theheraldproject/herald-hardware/wearable/images/beacon-usb.png

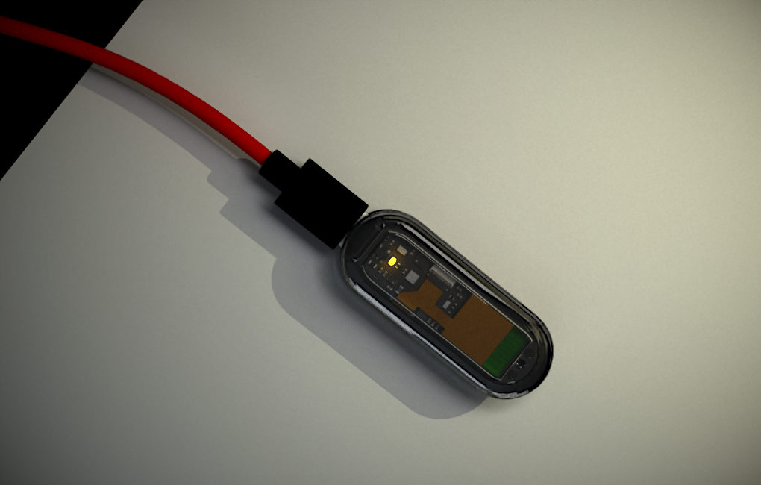
wearable/images/beacon-usb.png
