theheraldproject/herald-hardware/wearable/images/wearable-bracelet.png

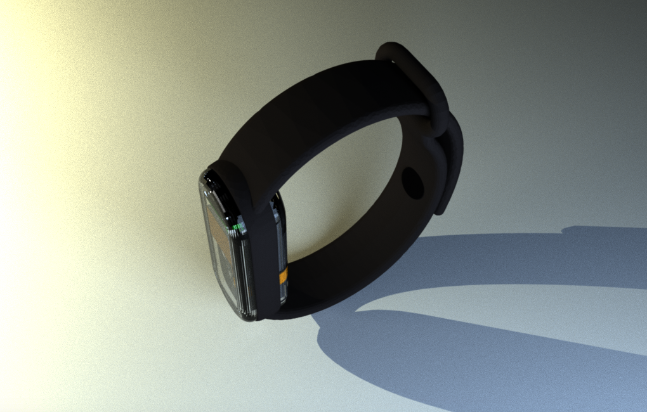
wearable/images/wearable-bracelet.png
