theheraldproject/herald-hardware/wearable/images/wearable-boards.png

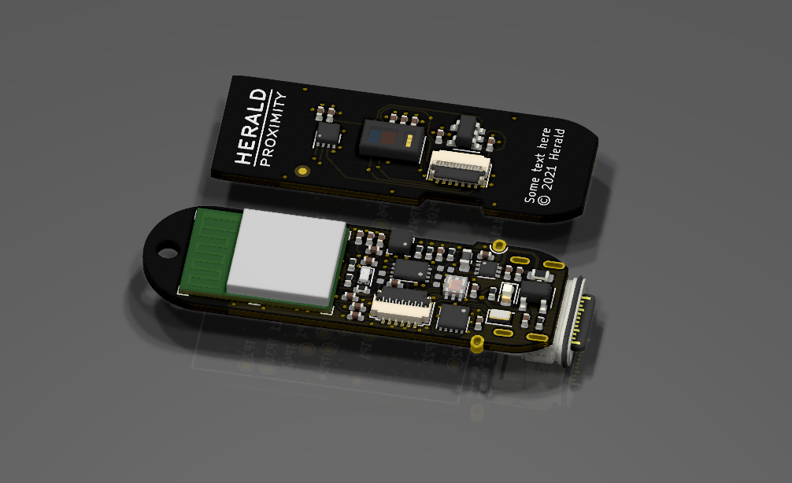
wearable/images/wearable-boards.png
