theheraldproject/herald-hardware/wearable/images/wearable-holder.png

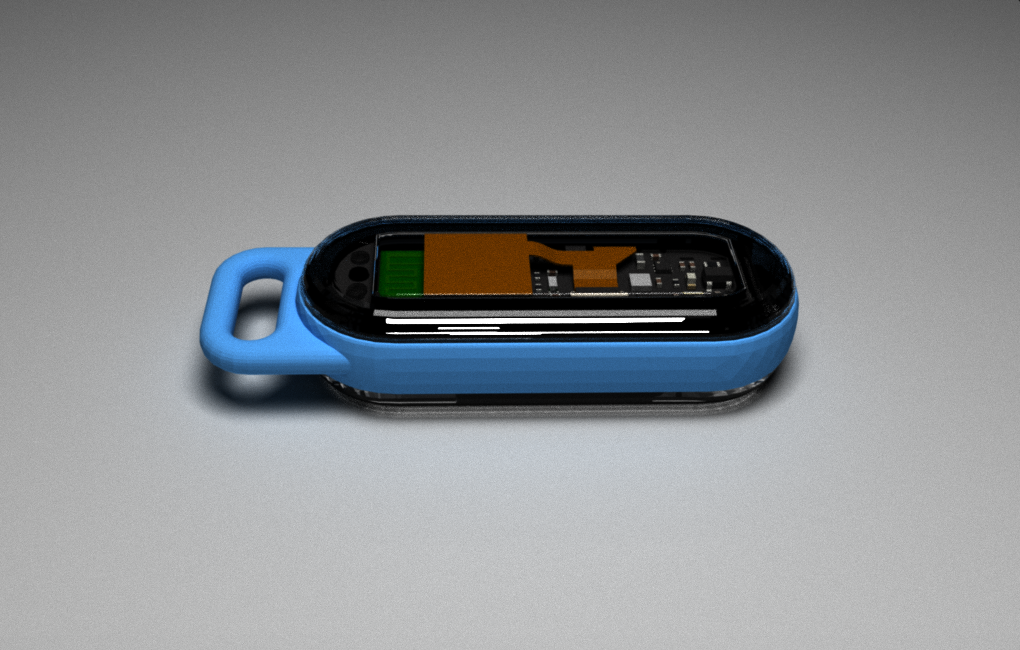
wearable/images/wearable-holder.png
