theheraldproject/herald-hardware/wearable/pcb/wearable.kicad_pcb

## KiCad design wearable/pcb/wearable.kicad_pcb (2021-12-06)

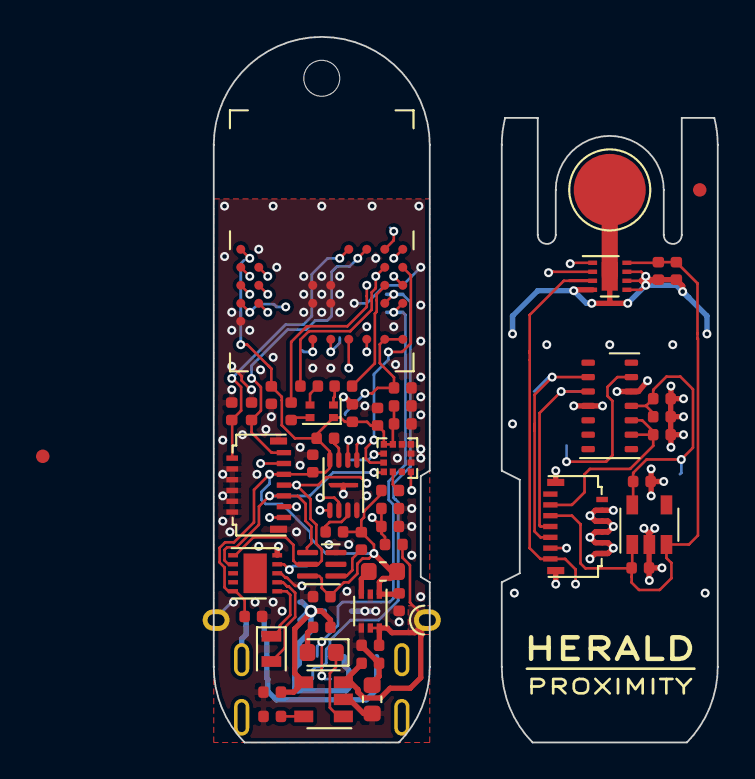
[picture p5: board wearable.kicad_pcb from above]

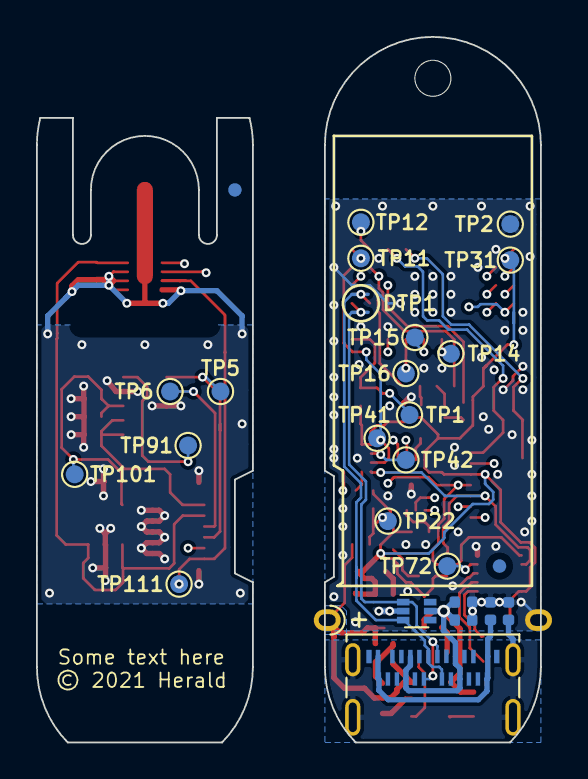
[picture p6: board wearable.kicad_pcb from below]

Board: 4 copper layers, 28.0 x 39.2 mm, 82 parts (26 on the bottom side), 47 nets.

Parts:
BT1: LiPo; Herald_Battery_Solder_Pads
C1, C11, C12, C21, C22, C112: 4.7uF; C_0402_1005Metric
C2: 100nF/100V; C_0402_1005Metric
C3, C31, C32, C41, C91, C93: 10uF; C_0402_1005Metric
C13, C14: 390pF; C_0402_1005Metric
C23: 10nF; C_0402_1005Metric
C42, C43, C61, C71, C92, C111: 100nF; C_0402_1005Metric
C51, C101, C102: 1uF; C_0402_1005Metric
D1: LED_ARBG; LED_Kingbright_APHF1608
D2: CHSTAT; LED_0603_1608Metric
FB1, FB2: 120R/0.6A; L_0402_1005Metric
FID1, FID2, FID3, FID4: Fiducial; Fiducial_0.75mm_Mask1.5mm
H1: MountingHole; MountingHole_2mm
H2: ThermalSlot; MillSlot_8.0x1.0mm
J1: USB_C_Receptacle_USB2.0; USB_C_Receptacle_IPxx
J2, J3: Extension; TE_1-2328724-3_2Rows_13Pins_P0.3mm_Horizontal
L31: 2.2uH; L_0603_1608Metric
R1: 0; R_0402_1005Metric
R2: 3.9k; R_0402_1005Metric
R3: 1k; R_0402_1005Metric
R4: 0; R_0603_1608Metric
R21, R41, R51, R61, R62: 10k; R_0402_1005Metric
R22: 5.6k; R_0402_1005Metric
R23: 6.8M; R_0402_1005Metric
R24: 10M; R_0402_1005Metric
TP1: VBUS; TestPoint_Pad_D1.0mm
TP2: GND; TestPoint_Pad_D1.0mm
TP5: SCL; TestPoint_Pad_D1.0mm
TP6: SDA; TestPoint_Pad_D1.0mm
TP11: SWDIO; TestPoint_Pad_D1.0mm
TP12: SWDCLK; TestPoint_Pad_D1.0mm
TP14: MISO; TestPoint_Pad_D1.0mm
TP15: MOSI; TestPoint_Pad_D1.0mm
TP16: SCLK; TestPoint_Pad_D1.0mm
TP22: BTSTAT; TestPoint_Pad_D1.0mm
TP31: VDD; TestPoint_Pad_D1.0mm
TP41: ACCINT1; TestPoint_Pad_D1.0mm
TP42: ACCINT2; TestPoint_Pad_D1.0mm
TP72: RTCINT; TestPoint_Pad_D1.0mm
TP91: BIOINT; TestPoint_Pad_D1.0mm
TP101: 1V8; TestPoint_Pad_D1.0mm
TP111: TMPINT; TestPoint_Pad_D1.0mm
TP112: ThPad; TestPoint_Pad_D4.0mm
U1: BC833; Fanstel_BC833x
U2: MCP73832-2-OT; SOT-23-5
U3: S-85S1A; SNT-6A
U4: LIS2DE12; LGA-12_2x2mm_P0.5mm
U5: APDS-9250; Broadcom_DFN-6_2x2mm_P0.65mm
U6: MX25R8035FZxxx0; USON-8-1EP_2x3mm_P0.5mm_EP0.25x1.65mm
U7: PCF85063ATL; DFN-10-1EP_2.6x2.6mm_P0.5mm_EP1.25x2.15mm
U8: DT1446-04V; SOT-563
U9: MAX30102; Maxim_OLGA-14_3.3x5.6mm_P0.8mm
U10: TCR3UFxxA; SOT-23-5
U11: TMP1075; WSON-8-1EP_2x2mm_P0.5mm_EP0.9x1.6mm
Y71: 32.768kHz; Crystal_SMD_2012-2Pin_2.0x1.2mm

Connections:
+1V8: C91.1, C92.1, C102.1, TP101.1, U9.11, U10.5
+BATT: BT1.1, C22.2, C31.1, J2.11, R23.1, U2.3, U3.5, U3.6
/Core Board/ACC_INT1: TP41.1, U1.17, U4.12
/Core Board/ACC_INT2: TP42.1, U1.4, U4.11
/Core Board/BIO_INT: J2.3, U1.2
/Core Board/BT_STAT: C23.1, R23.2, R24.1, TP22.1, U1.6
/Core Board/CH_STAT: D2.1, U2.1
/Core Board/FLASH_CS: U1.7, U6.1
/Core Board/FLASH_RST: R61.2, U6.7
/Core Board/FLASH_WP: R62.2, U6.3
/Core Board/LED_B: R1.1, U1.21
/Core Board/LED_G: R2.1, U1.16
/Core Board/LED_R: R3.1, U1.20
/Core Board/LS_INT: R51.2, U5.4
/Core Board/MISO: TP14.1, U1.9, U6.2
/Core Board/MOSI: TP15.1, U1.10, U6.5
/Core Board/NFC1: C13.1, J2.13, U1.23
/Core Board/NFC2: C14.1, J2.12, U1.24
/Core Board/RTC_INT: TP72.1, U1.3, U7.4
/Core Board/SCL: J2.5, U1.12, U4.1, U5.1, U7.7
/Core Board/SCLK: TP16.1, U1.11, U6.6
/Core Board/SDA: J2.7, U1.8, U4.4, U5.2, U7.6
/Core Board/SWDCLK: TP12.1, U1.22
/Core Board/SWDIO: TP11.1, U1.18
/Core Board/USB_D+: J1.A6, J1.B6, U1.19, U8.3
/Core Board/USB_D-: J1.A7, J1.B7, U1.15, U8.1
/Extension Board/BIO_INT: J3.11, TP91.1, U9.13
/Extension Board/SCL: J3.9, TP5.1, U9.2, U11.2
/Extension Board/SDA: J3.7, TP6.1, U9.3, U11.1
/Extension Board/TMP_INT: J3.13, TP111.1, U11.3
Earth: FB1.1, J1.S1
GND: BT1.2, C1.1, C2.1, C3.2, C11.2, C12.2, C13.2, C14.2, C21.1, C22.1, C23.2, C31.2, C32.2, C41.2, C42.2, C43.2, C51.2, C61.1, C71.2, FB1.2, FB2.2, J2.2, J2.4, J2.6, J2.8, J2.10, J2.MP, R4.1, R4.2, R21.2, R24.2, TP2.1, U1.5, U1.25, U1.26, U1.27, U1.28, U2.2, U3.2, U3.4, U4.5, U4.6, U4.7, U4.8, U5.6, U6.4, U6.EP, U7.3, U7.5, U8.2
GND1: C91.2, C92.2, C93.2, C101.2, C102.2, C111.1, C112.1, J3.4, J3.6, J3.8, J3.10, J3.12, J3.MP, TP112.1, U9.4, U9.12, U10.2, U11.4, U11.5, U11.6, U11.7, U11.9
GNDPWR: FB2.1, J1.A1, J1.A12, J1.B1, J1.B12
unnamed: D1.2, R3.2
unnamed: D1.3, R1.2
unnamed: D1.4, R2.2
unnamed: D2.2, R22.1
unnamed: L31.2, U3.3
unnamed: R21.1, U2.5
unnamed: R41.2, U4.2
unnamed: U7.1, Y71.1
unnamed: U7.2, Y71.2
VBUS: C1.2, C2.2, C11.1, C21.2, J1.A4, J1.A9, J1.B4, J1.B9, R22.2, TP1.1, U1.13, U1.14, U2.4, U8.5
VDD: C3.1, C12.1, C32.1, C41.1, C42.1, C43.1, C51.1, C61.2, C71.1, D1.1, J2.9, L31.1, R41.1, R51.1, R61.1, R62.1, TP31.1, U1.1, U3.1, U4.9, U4.10, U5.3, U6.8, U7.10
VDD1: C101.1, C111.2, C112.2, J3.5, U10.1, U10.3, U11.8
Vdrive: C93.1, J3.3, U9.9, U9.10
