theheraldproject/herald-hardware/wearable/fpc/fpc.kicad_pcb

## KiCad design wearable/fpc/fpc.kicad_pcb (2021-05-15)

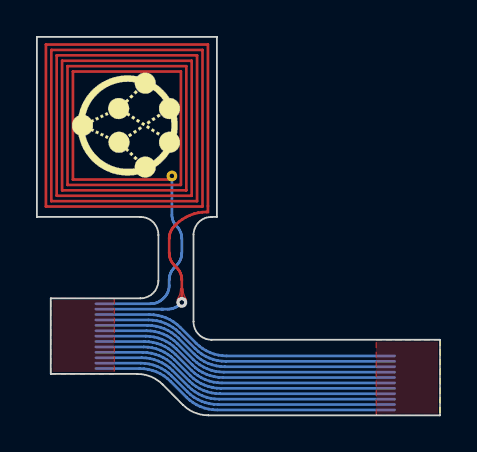
[picture p7: board fpc.kicad_pcb from above]

Board: 2 copper layers, 22.4 x 21.0 mm, 3 parts (0 on the bottom side), 9 nets.

Parts:
AE1: NFC; NFC_9x9mm_T6_W0.15mm_P0.3mm
J1, J2: FPC; TE_1-2328724-3_2Rows_13Pins_P0.3mm_FPC

Connections:
/BATT: J1.11, J2.3
/BIO_INT: J1.3, J2.11
/NFC1: AE1.2, J1.12
/NFC2: AE1.1, J1.13
/SCL: J1.5, J2.9
/SDA: J1.7, J2.7
/TMP_INT: J1.1, J2.13
/VDD: J1.9, J2.5
GND: J1.2, J1.4, J1.6, J1.8, J1.10, J2.4, J2.6, J2.8, J2.10, J2.12
