theheraldproject/herald-hardware/(commit log)

2021-04-12 Initial import of the Herald Wearable Beacon hardware files.
    The device can be used as both a weareable or a beacon. It features
    nRF52833 SoC packaged in BC833M module, flash memory, and number
    of sensors, including:
    - accelerometer for device control
    - four-channel light sensor for environment sensing
    - pulse oximeter and temperature sensors for health monitoring
    [wearable-core.sch, wearable-ext.sch, wearable.kicad_pcb, wearable.sch]
2021-04-12 Add 3D models of the USB-C and FPC connectors.
    The models are derived from the STEP files provided by the Amphenol/ICC
    and the TE Connectivity. Please see external/README for details.
    [wearable.kicad_pcb]
2021-04-12 Provide 3D model for housing for the Wearable/Beacon.
2021-04-12 Work out the fabrication layers.
    [wearable.kicad_pcb]
2021-04-13 Fixes #6. Added PCB boards image
    Fixes #6.
2021-04-14 Import the FPC+NFC ribbon cable.
    The cable connects top and bottom boards, and offers an NFC antenna.
    [fpc.kicad_pcb, fpc.sch]
2021-04-15 The bill of materials has been completed.
    While working on the BoM, fix error in the battery sensing circuit.
    The R23 must be 6.8M or bigger (previously was 4M). This is required
    to keep the ADC voltage below VDD=2.5V value.
    [wearable-core.sch, wearable-ext.sch, wearable.kicad_pcb]
2021-04-15 Some BoM fixes popped up after uploading it to the Octopart.
    [wearable-core.sch]
2021-05-05 Review the wearable ribbon cable for manufacturing.
    - Do teardrops at vias.
    - Make it up with logo & copyright text.
    [fpc.kicad_pcb]
2021-05-05 Wearable renders: fix the USB charging LED.
2021-05-15 Nordic Review: make ground area on the top layer solid.
    To acheive this, route NFC traces on the bottom size, make the
    BC833M pad connection to zones solid, and move some test points
    across the board.
    Also, temporarily remove the front fiducial from the core board.
    It will be placed later when the boards will get panelized.
    [wearable.kicad_pcb]
2021-05-24 Adjust the BoM to include only the stocked components.
    [wearable-core.sch, wearable-ext.sch]
2021-05-27 Completely rework the temperature sensor layout.
    Now, use a dedicated thermal guide to the IC exposed pad, and
    decouple the sensor from the rest of the board.
    [wearable-ext.sch, wearable.kicad_pcb]
2021-05-28 Make pcbnew DRC happy.
    This improves pad-to-pad clearance for the SOT-563 packages,
    and allows overlapping footprints (yep, real estate is expenisve).
    [wearable-core.sch, wearable.kicad_pcb]
2021-05-28 Create in-housing thermal guide to the TMP1075 sensor.
2021-07-19 Nordic review: drop current limiting resitors from the USB.
    Per @msromero: For D+ and D- lines it's recommend to get rid of the
    22R resistors in parallel of the TVS diodes, since you can risk
    failing USB testing.
    Thanks!
    [wearable-core.sch, wearable.kicad_pcb]
2021-07-19 Mark thermal slots/pads in the BoM accordingly.
    [wearable-ext.sch]
2021-07-19 Tune the LED resistors.
    The RGB LED resistors were tuned on a real board with 2.5V driver
    voltage. It happens the blue LED should be zero Ohm limited, and
    then red and green LEDs adjusted to the neutral white.
    The charge LED looks good with 5.1k, but more standard 5.6k should
    also work just fine.
    [wearable-core.sch, wearable.kicad_pcb]
2021-07-21 Tune the NFC antenna.
    The antenna design is in the wearable/fpc directory.
    S11: https://twitter.com/mishkathebear/status/1417551022650691590/photo/1
    [wearable-core.sch, wearable.kicad_pcb]
2021-07-23 Describe electrical configuration of the interrupt lines.
    [wearable-core.sch, wearable-ext.sch]
2021-09-29 Improve the USB receptacle fitting inside the housing.
