theheraldproject/herald-hardware/(notices)

Notices in the files:
wearable/pcb/wearable-ext.sch:
© 2021 Herald Project Contributors
Licensed under CERN-OHL-P version 2
wearable/pcb/wearable.kicad_pcb:
© 2021 Herald
